cahartsell/DataAcquisition/CAD_files/README.md

Various 3D CAD models for electrical systems on (or related to) the car
