cahartsell/DataAcquisition/AndroidApp/README.md

Android app to download data from on-board data aquisition system over Bluetooth.
