cahartsell/DataAcquisition/Arduino/README.md

## Arduino Source Code

This directory contains all source code intended to run on an Arduino (MEGA ideally)

Written in standard C++ (not arduino C). Compiled and deployed to Arduino using PlatformIO.

Project is configured for Eclipse IDE (Due to PlatformIO support for Eclipse).
