cahartsell/DataAcquisition/PythonBluetoothServer/README.md

Simple Python bluetooth server for testing android app (without Arduino bluetooth)
