cahartsell/DataAcquisition/Documents_Presentations/Baja Innovation Presentation (Auburn Design Review Event).pptx

Bama Racing Innovation

Charles Hartsell & John Mitchell

## Data Acquisition System

- Arduino MEGA 2560
- Data Gathered:
  - Drive Axle RPM
  - Engine RPM
  - Vehicle Acceleration
  - CVT Temperature

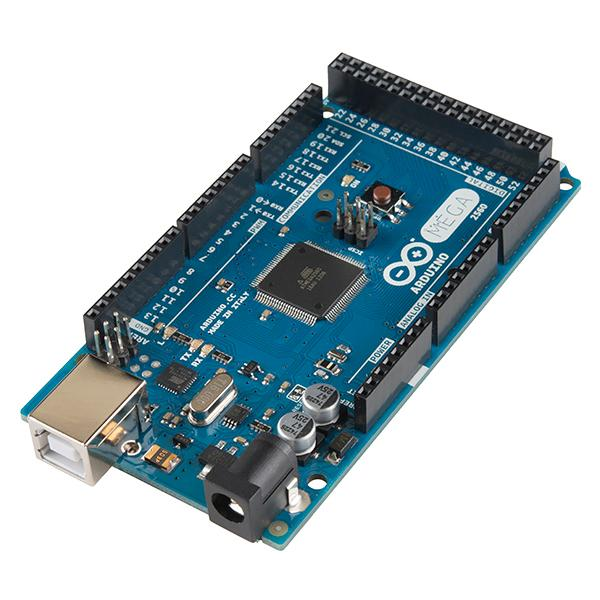
[picture p1: figure]

## Data Logging

- Serial Interface with in-vehicle micro SD card
- Logs data from sensors:
  - Engine RPM
  - Axle RPM
  - Acceleration
- CVT ratio determined using Engine & Axle RPM

## Driver Interface

- 16x2 LCD Display:
  - Current Speed
  - Hour meter
  - Odometer
  - Tachometer

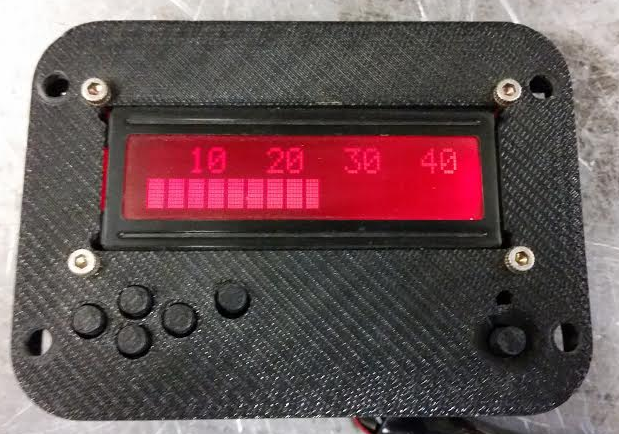
[picture p2: figure]
Screen Clipping

## Engine RPM Sensor

- Capacitive pickup on spark plug wire
- Noisy input
- 74221 monostable multivibrator (aka “one-shot”) used to provide clean rectangular pulse to Arduino

## Axle RPM Sensor

- GM camshaft position sensor (inductive pickup)
- Op-Amp circuit to boost the signal to 5V logic level

## 3-Axis Accelerometer

- I2C interface with microcontroller through 3.3 to 5V Logic Leveler
- Selectable range of ±2g/ ±4g/ ±8g
- Secondary Speed measurement
- Vehicle Orientation

## Power Consumption

- Typical Current Draw:
  - Brake/Reverse Light: 100 mA each
  - Reverse Alarm: 70 mA
  - Arduino: 25 mA under load
  - Sensors/Screen: 20 mA typical
- Significant power consumption by Data Acquisition System
- 5 Ah battery chosen for long battery life (approximately 55 hours)

## Dashboard

- Low-Profile for Driver Visibility
- 3D Printed for ease of manufacture and light weight
- Total Weight (inc. DAS): ~4 lbs

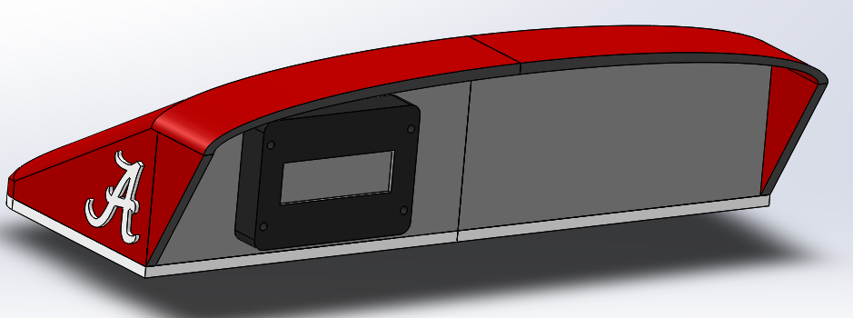
[picture p3: figure]

## Slide 10

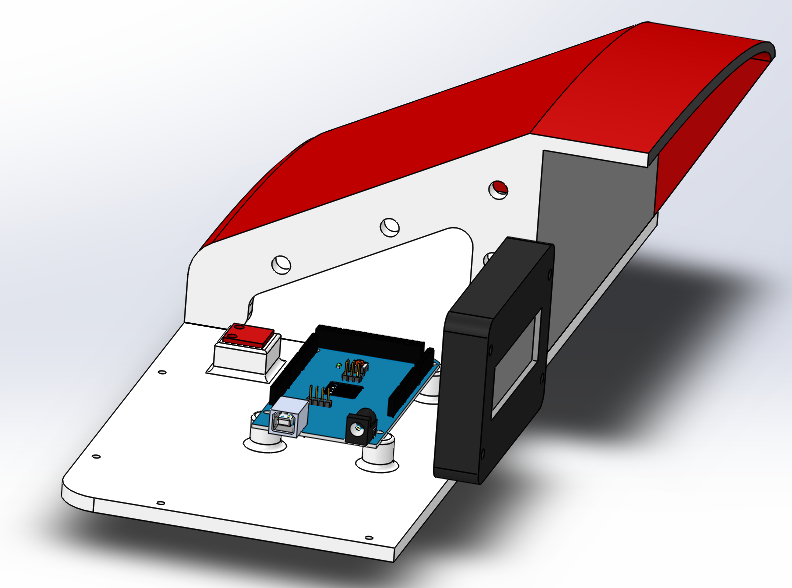
[picture p4: figure]

## Cost Report

- Arduino MEGA: 45.95
- Display: 8.20
- Accelerometer: 9.95
- Position Sensor: 25.28
- Temp Sensor: 1.50
- Misc: ~20.00
- Total: 110.88
- Entire Electrical Cost: 391.78
