cahartsell/DataAcquisition/MATLAB/ExamplePlots.png

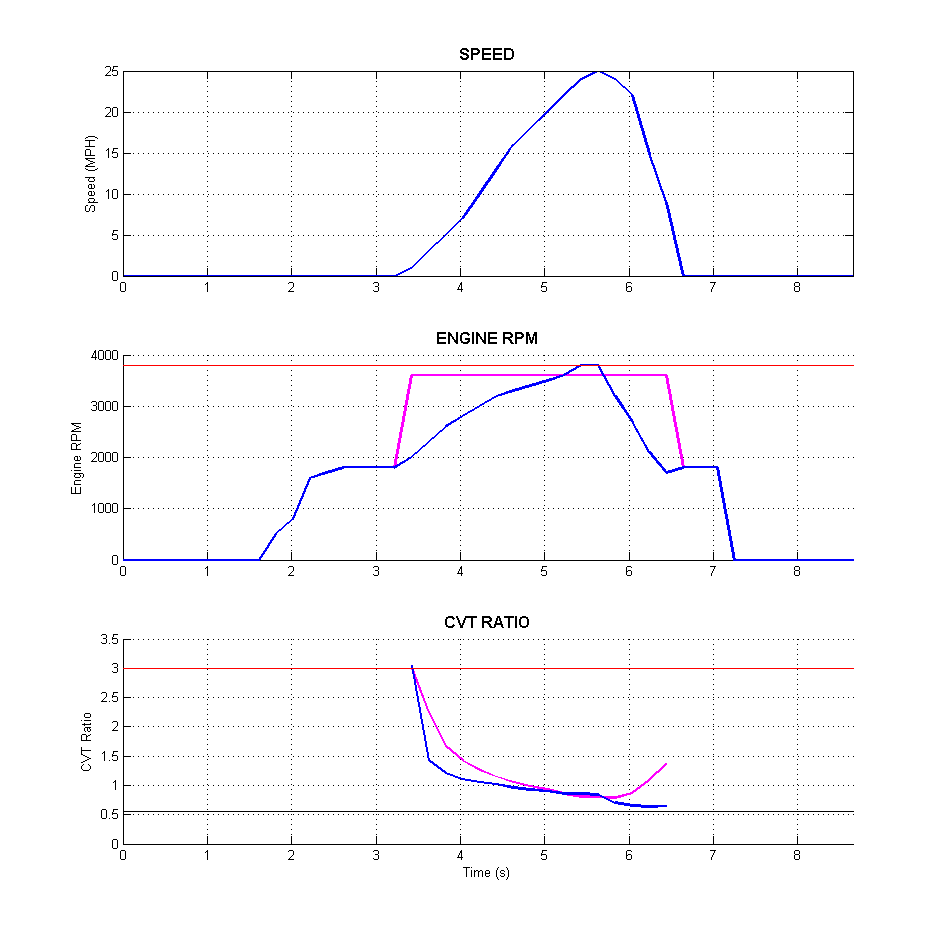
MATLAB/ExamplePlots.png
