cahartsell/DataAcquisition/raspberrypi/component_tests/README.md

Component tests copied over from Arduino code.
Must be converted to a standard C/C++ file using R-PI libraries before running on raspberry pi.
