cahartsell/DataAcquisition/Documents_Presentations/Electrical Ideas Parts List.xlsx

Baja Electrical Parts List: 2014-2015
Part | Amount | Price | Source
Must have:
Back-up/Reverse Light Combo | 1 | $39.78 | http://www.waytekwire.com/item/47945/6-OVAL-DUAL-LED-STOP-TURN/
Connector for Light | 5 | $0.96 | http://www.waytekwire.com/item/47998/CONNECTOR-PIGTAIL-RIGHT-ANGLE-U-S-Made-/
2 Terminal Microswitch | 1 | $1.50 | https://www.sparkfun.com/products/9414
Back-up Alarm | 1 | $22.43 | http://www.waytekwire.com/item/48020/BACK-UP-ALARM-97DB/
 | Total: | $64.67
Needed:
3 Axis Accelerometer | 1 | $9.95 | https://www.sparkfun.com/products/12756
Sparkfun Open Log | 1 | $24.95 | https://www.sparkfun.com/products/9530
Arduino Mega Proto Shield | 1 | $14.95 | http://www.adafruit.com/products/192
Connector 10-Pack (Plugs) | 1 | $3.86 | http://www.mcmaster.com/#69295k99/=vitq33
Connector 10-Pack (Recepticals) | 1 | $3.86 | http://www.mcmaster.com/#69295k8/=vitqj1
Pins 100-Pack | 1 | $11.35 | http://www.mcmaster.com/#69295k111/=vitr4v
Sockets 100-Pack | 1 | $10.27 | http://www.mcmaster.com/#69295k115/=vitr6y
 | Total: | $79.19
Extra:
Inline Watt Meter | 1 | $49.99 | http://www.powerwerx.com/digital-meters/dc-inline-watt-meter-power-analyzer-powerpoles.html
Anderson Powerpoles | 1 | $37.99 | http://www.powerwerx.com/anderson-powerpoles/powerpole-sets/15-amp-red-black-anderson-powerpole-sets.html
 | Total: | $87.98
 | Grand Total: | $167.17
16GB SD Card | 1 | $8.93 | http://www.amazon.com/SanDisk-Memory-SDSDUN-0016G-G46-Newest-Version/dp/B00M55BMKK?s=pc
