cahartsell/DataAcquisition/CAD_files/Dashboard Assembly/HUD Assem2.SLDASM

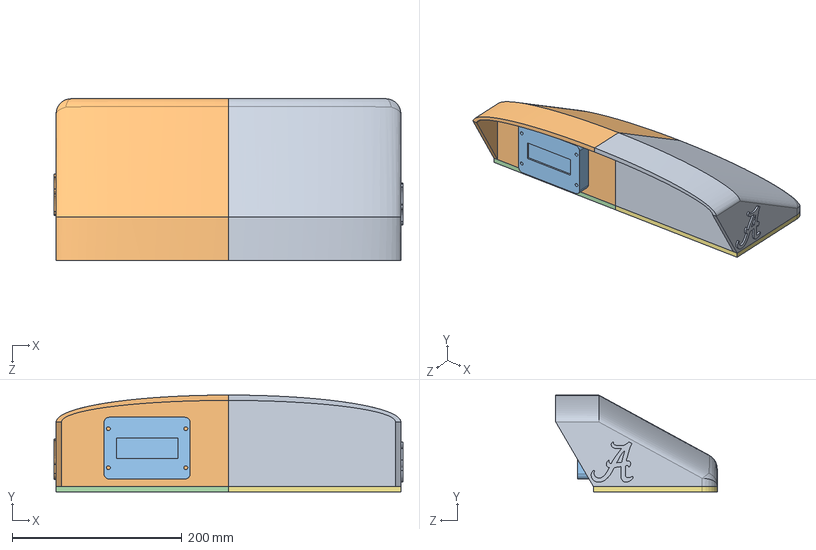
[picture p8: CAD file, 2018-06-14]
CAD_files/Dashboard Assembly/HUD Assem2.SLDASM
411.5 x 114.3 x 190.5 mm
SPLIT HUD 2.1
SPLIT HUD 1.1
LCD Box
Dash Bottom Half
ArduinoMega2560
Accelerometer
Dash Bottom Right Half
