cahartsell/DataAcquisition/CAD_files/Small Dash Assembly V2/Dash Assembly.SLDASM

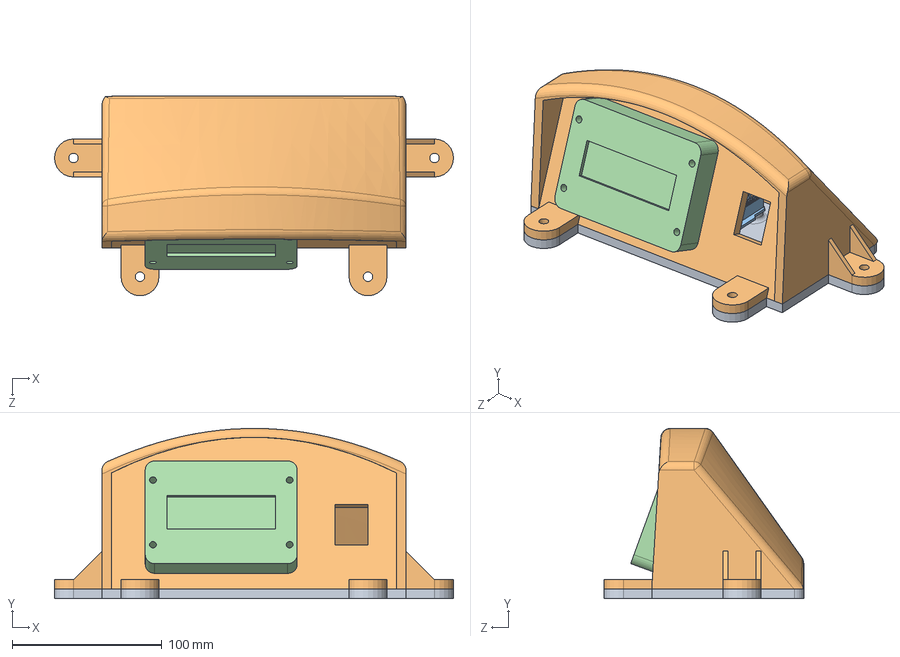
[picture p9: CAD file, 2018-06-14]
CAD_files/Small Dash Assembly V2/Dash Assembly.SLDASM
266.7 x 113.8 x 133.4 mm
Dash Bottom
Dash
ArduinoMega2560
LCD Box
Accelerometer
