cahartsell/DataAcquisition/CAD_files/Small Dash Assembly/Small Dash Assembly.SLDASM

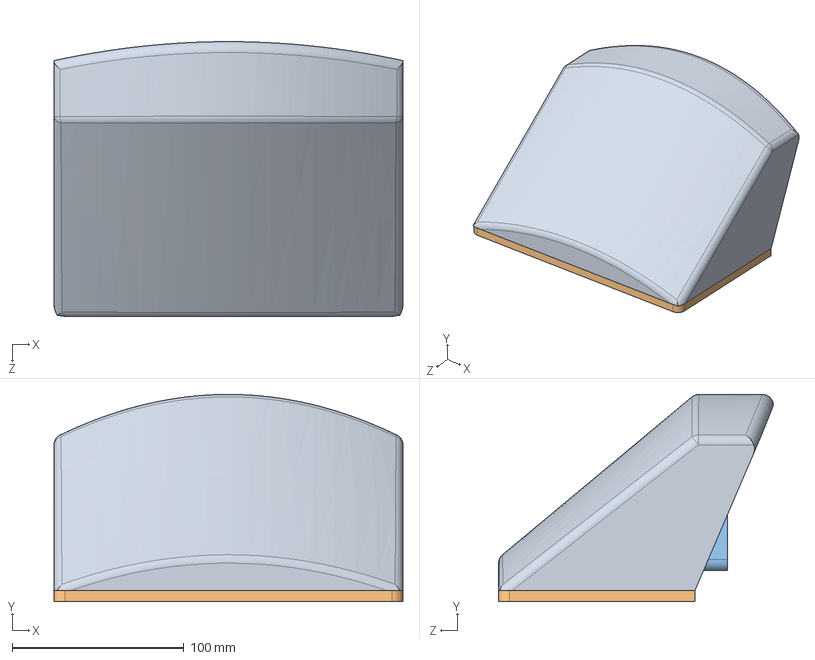
[picture p10: CAD file, 2018-06-14]
CAD_files/Small Dash Assembly/Small Dash Assembly.SLDASM
203.2 x 120.6 x 160.0 mm
Small Dash
Small Dash Bottom
LCD Box
ArduinoMega2560
