cahartsell/DataAcquisition/CAD_files/Small Dash Assembly V2/LCD Box.SLDPRT

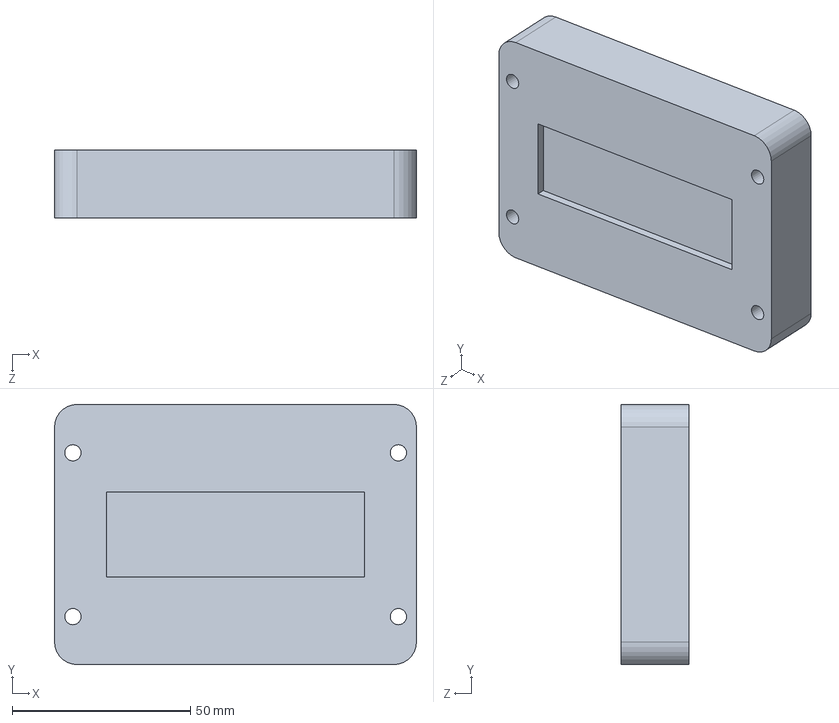
[picture p12: CAD file, 2018-06-14]
CAD_files/Small Dash Assembly V2/LCD Box.SLDPRT
101.6 x 73.0 x 19.1 mm
