cahartsell/DataAcquisition/CAD_files/Small Dash Assembly/Small Dash.SLDPRT

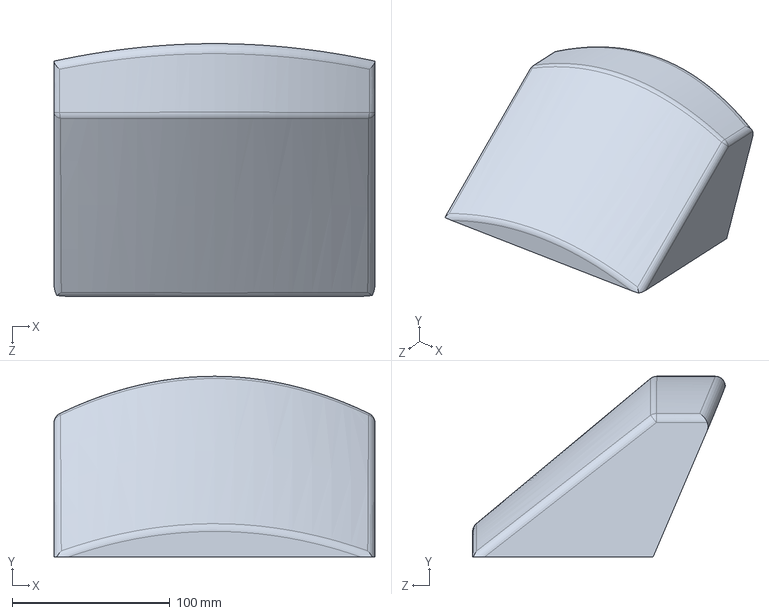
[picture p13: CAD file, 2018-06-14]
CAD_files/Small Dash Assembly/Small Dash.SLDPRT
203.2 x 114.3 x 160.0 mm
