cahartsell/DataAcquisition/CAD_files/Transponder Charging Holder.SLDPRT

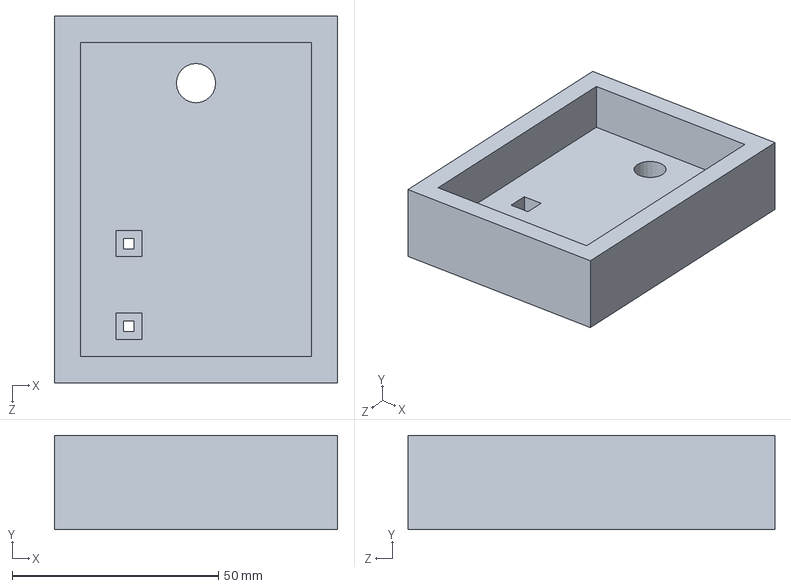
[picture p14: CAD file, 2018-06-14]
CAD_files/Transponder Charging Holder.SLDPRT
68.6 x 22.9 x 88.9 mm
