cahartsell/DataAcquisition/CAD_files/Transponder Charging Holder v2.SLDPRT

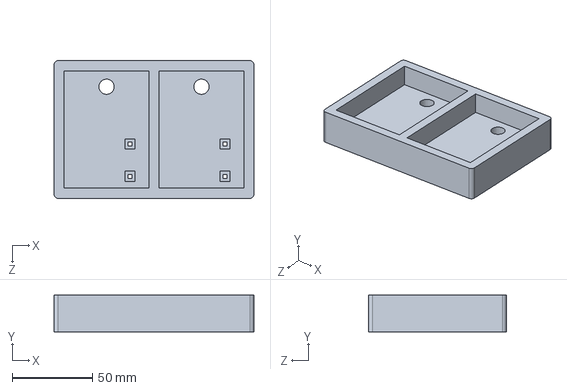
[picture p15: CAD file, 2018-06-14]
CAD_files/Transponder Charging Holder v2.SLDPRT
124.5 x 22.9 x 85.7 mm
