cahartsell/DataAcquisition/CAD_files/Battery Model.SLDPRT

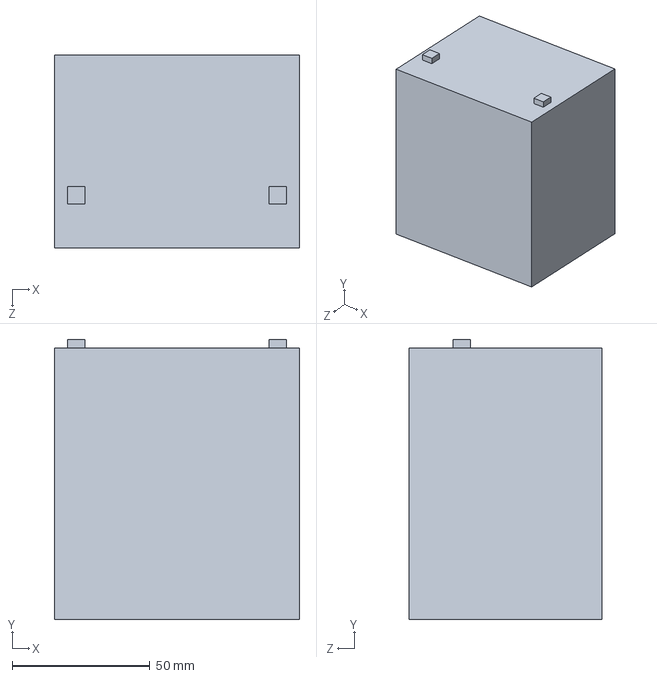
[picture p16: CAD file, 2018-06-14]
CAD_files/Battery Model.SLDPRT
88.9 x 101.6 x 69.8 mm
