cahartsell/DataAcquisition/CAD_files/Dashboard Assembly/Dash Bottom Right Half.SLDPRT

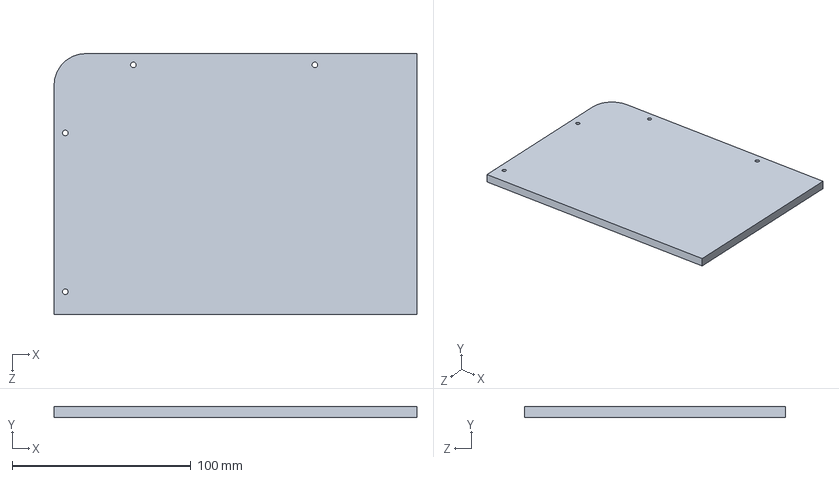
[picture p17: CAD file, 2018-06-14]
CAD_files/Dashboard Assembly/Dash Bottom Right Half.SLDPRT
203.2 x 6.35 x 146.1 mm
