cahartsell/DataAcquisition/CAD_files/Small Dash Assembly V2/Accelerometer.SLDPRT

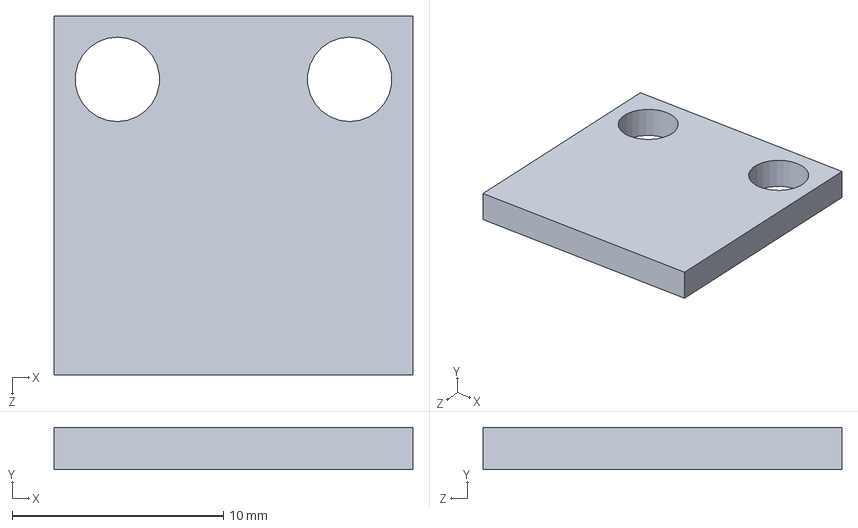
[picture p18: CAD file, 2018-06-14]
CAD_files/Small Dash Assembly V2/Accelerometer.SLDPRT
17.0 x 2.00 x 17.0 mm
