cahartsell/DataAcquisition/CAD_files/Dashboard Assembly/ArduinoMega2560R3.stp

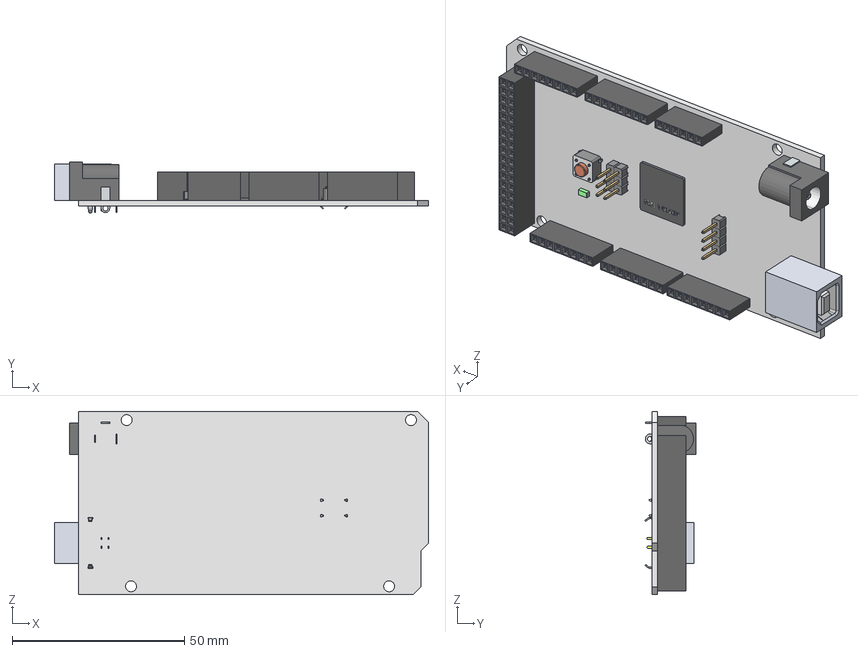
[picture p19: CAD file, 2018-06-14]
CAD_files/Dashboard Assembly/ArduinoMega2560R3.stp
108.6 x 14.9 x 53.2 mm
PCB-FIXED
