cahartsell/DataAcquisition/CAD_files/Small Dash Assembly V2/Dash.SLDPRT

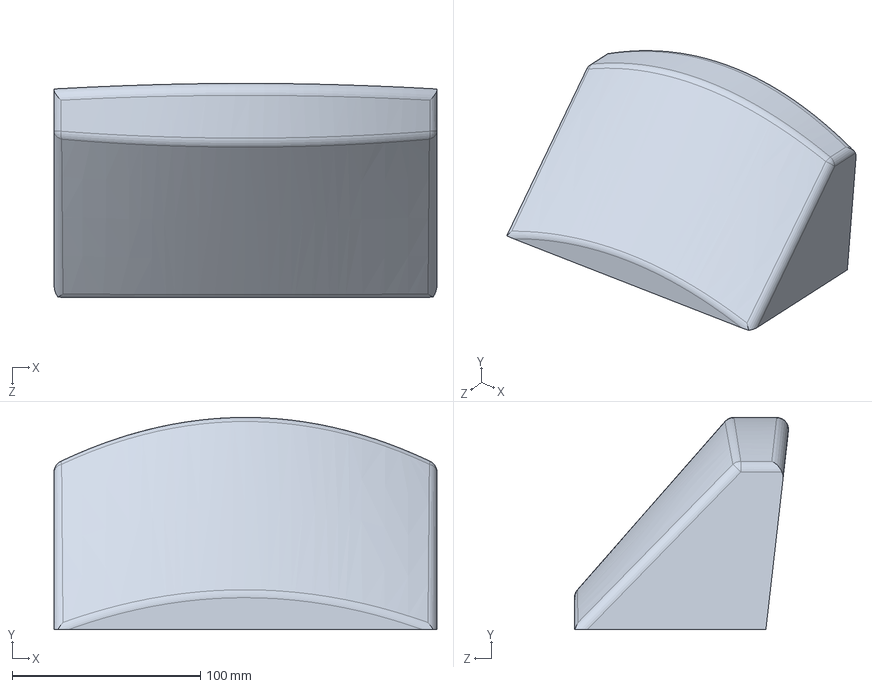
[picture p20: CAD file, 2018-06-14]
CAD_files/Small Dash Assembly V2/Dash.SLDPRT
203.2 x 112.6 x 113.6 mm
