cahartsell/DataAcquisition/CAD_files/Small Dash Assembly/Small Dash Bottom.SLDPRT

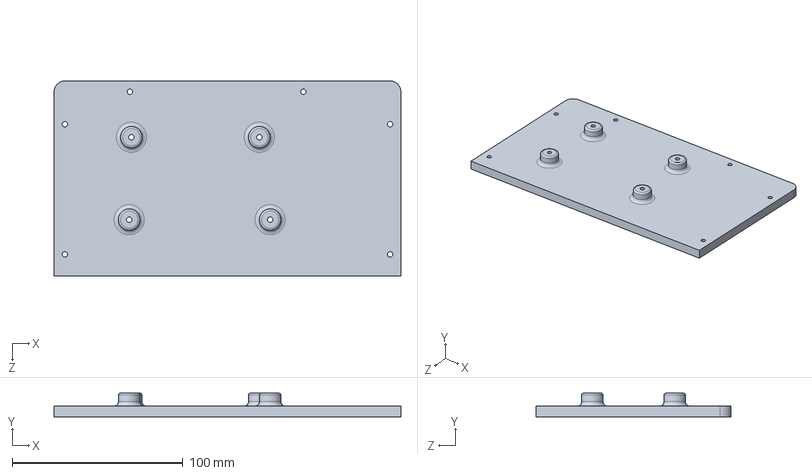
[picture p21: CAD file, 2018-06-14]
CAD_files/Small Dash Assembly/Small Dash Bottom.SLDPRT
203.2 x 14.0 x 114.3 mm
