cahartsell/DataAcquisition/CAD_files/Dashboard Assembly/SPLIT HUD 2.1.SLDPRT

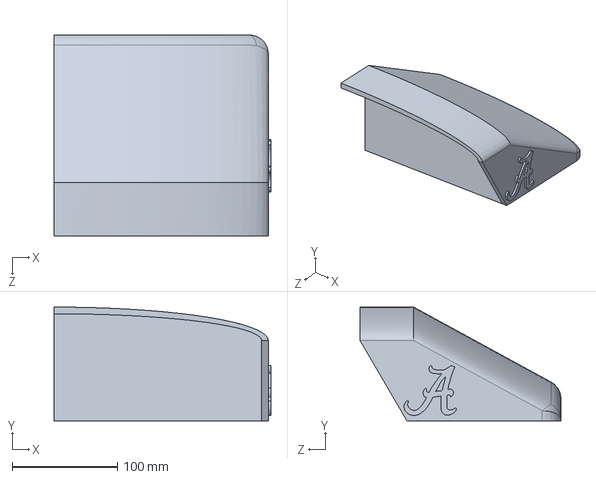
[picture p22: CAD file, 2018-06-14]
CAD_files/Dashboard Assembly/SPLIT HUD 2.1.SLDPRT
205.7 x 108.0 x 190.5 mm
