cahartsell/DataAcquisition/CAD_files/Small Dash Assembly V2/Dash Bottom.SLDPRT

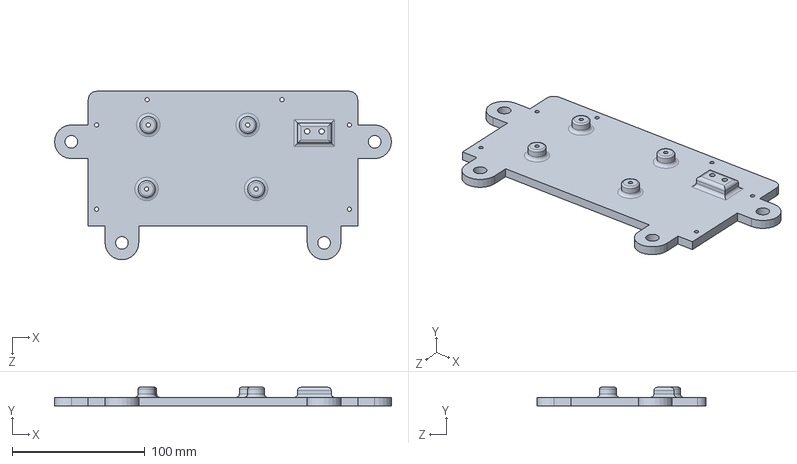
[picture p23: CAD file, 2018-06-14]
CAD_files/Small Dash Assembly V2/Dash Bottom.SLDPRT
254.0 x 14.0 x 127.0 mm
