cahartsell/DataAcquisition/CAD_files/Dashboard Assembly/Dash Bottom Half.SLDPRT

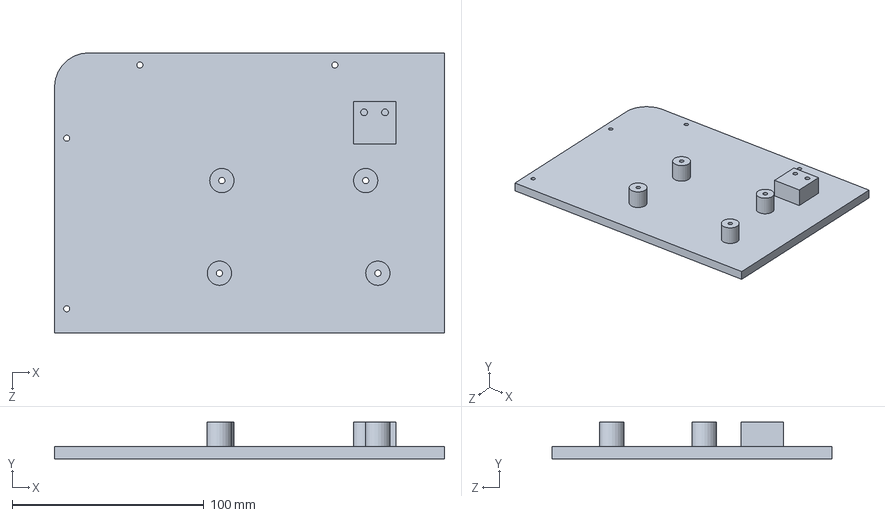
[picture p24: CAD file, 2018-06-14]
CAD_files/Dashboard Assembly/Dash Bottom Half.SLDPRT
203.2 x 19.1 x 146.1 mm
