cahartsell/DataAcquisition/CAD_files/Dashboard Assembly/Arduino Mega Case.SLDPRT

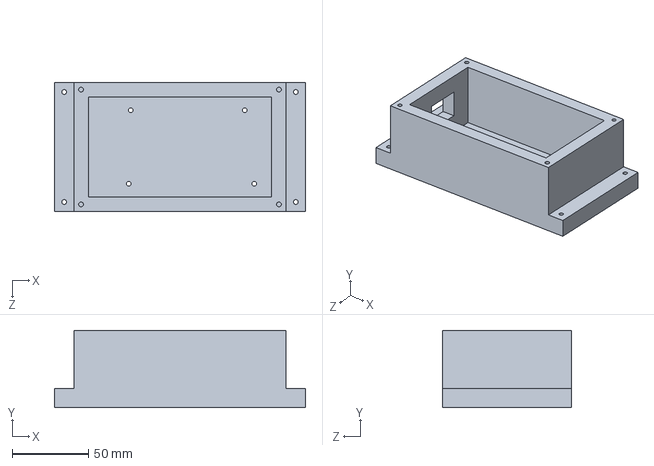
[picture p25: CAD file, 2018-06-14]
CAD_files/Dashboard Assembly/Arduino Mega Case.SLDPRT
165.1 x 50.8 x 85.1 mm
