cahartsell/DataAcquisition/CAD_files/Dashboard Assembly/Arduino Mega Case Lid.SLDPRT

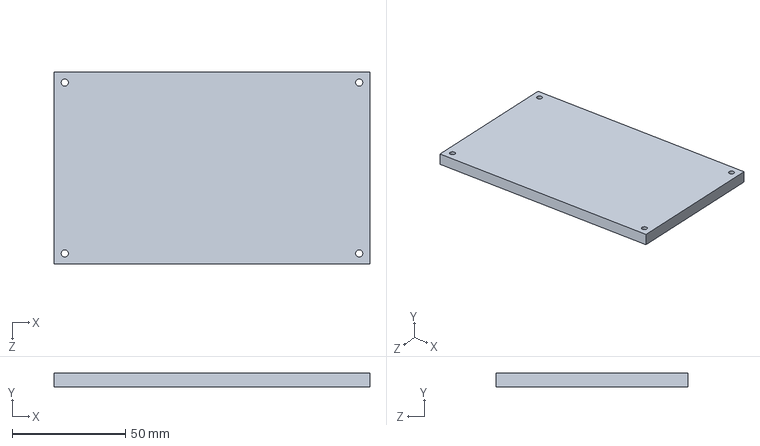
[picture p26: CAD file, 2018-06-14]
CAD_files/Dashboard Assembly/Arduino Mega Case Lid.SLDPRT
139.7 x 6.35 x 85.1 mm
