cahartsell/DataAcquisition/(list of files, cad)

Other CAD files:
CAD_files/Small Dash Assembly/ArduinoMega2560.SLDPRT
CAD_files/Dashboard Assembly/SPLIT HUD 1.1.SLDPRT
CAD_files/Small Dash Assembly V2/ArduinoMega2560.SLDPRT
CAD_files/Dashboard Assembly/LCD Box.SLDPRT
CAD_files/Small Dash Assembly V2/Dash Bottom.STL
CAD_files/Small Dash Assembly V2/Dash.STL
