cahartsell/DataAcquisition/CAD_files/Dashboard Assembly/Screenshots.docx

Mass = ~3.70 lbs inc. LCD Box

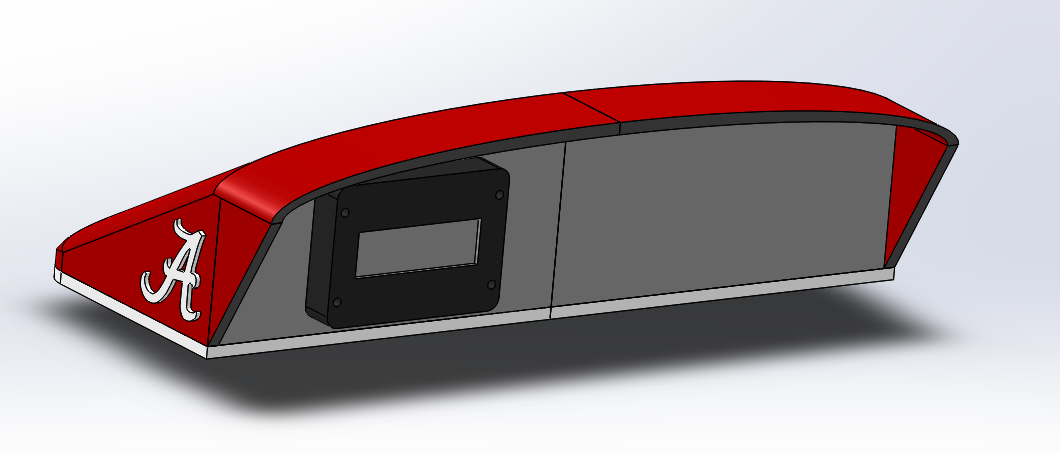
[picture p27: figure]
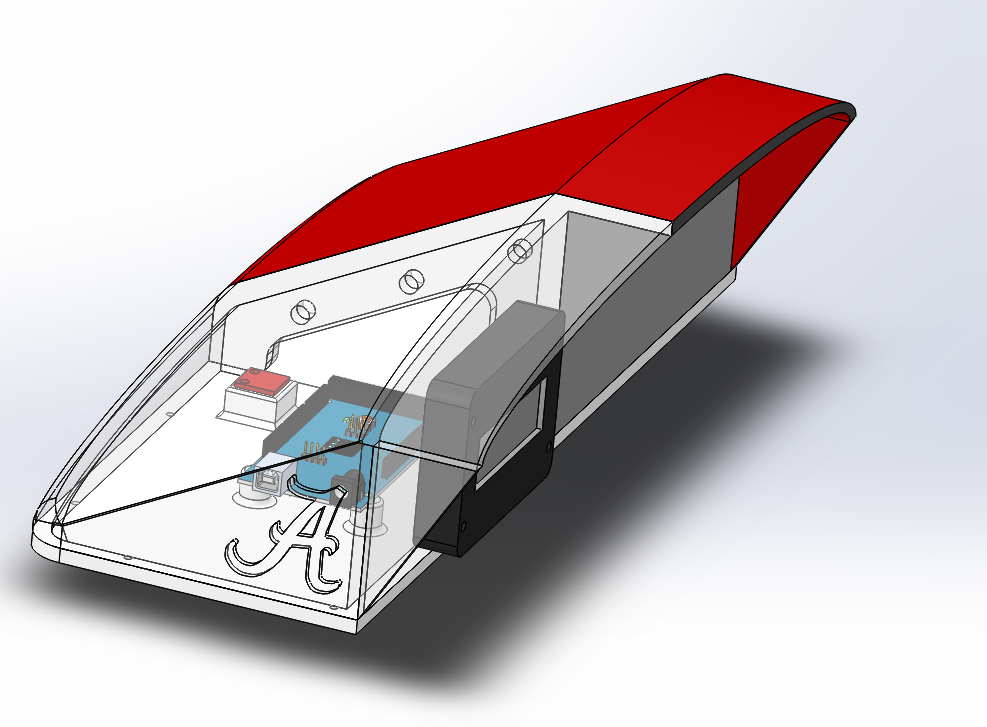
[picture p28: figure]
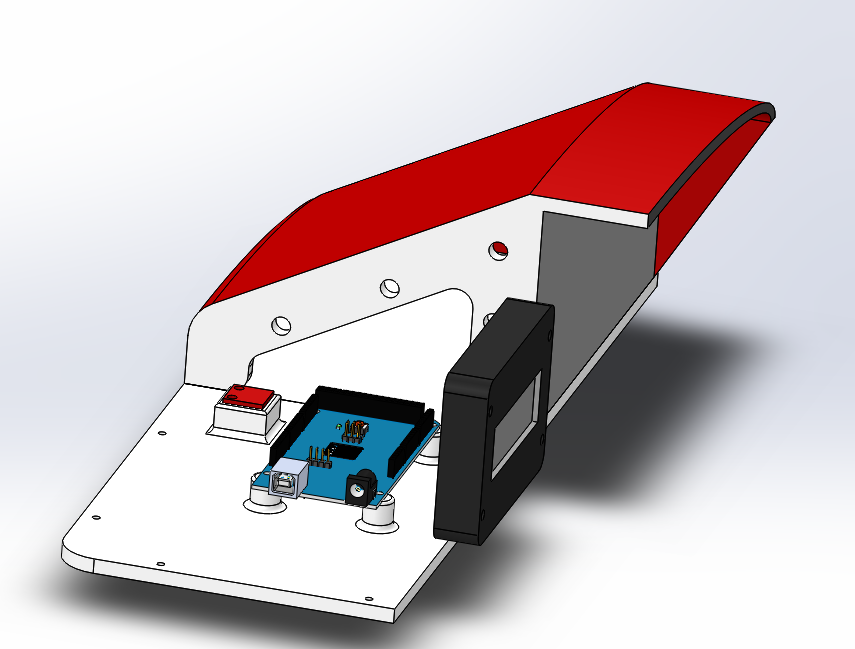
[picture p29: figure]
