cahartsell/DataAcquisition/(list of files, drawings)

Other design files:
PCB Files/bajaV1.dip
PCB Files/bajaV2.dip
