cahartsell/DataAcquisition/(commit log)

2018-06-14 Consolidated files into single repo
    [Accelerometer.SLDPRT, Arduino Mega Case Lid.SLDPRT, Arduino Mega Case.SLDPRT, ArduinoMega2560.SLDPRT, ArduinoMega2560R3.stp, Battery Model.SLDPRT, Dash Assembly.SLDASM, Dash Bottom Half.SLDPRT]
2018-07-10 Initial C++ project for raspberry pi
2018-07-15 Added wiringPi library as submodule
2018-07-15 Added raspberry pi GPIO test
2018-07-23 Reorganized repo and added initial raspberry pi code
2018-07-23 Bug fixes in raspberry pi code and modified DevVM startup script
    [logger.cpp, sparkplugsensor.cpp, sparkplugsensor.h]
2018-07-23 Compiled wiringPi library
2018-07-24 Small bug fix with ISR
    [sparkplugsensor.cpp]
2018-07-25 Bug fix with volatile timespec in ISR
    [sparkplugsensor.cpp]
2018-07-25 Bug fix with gettime in ISR
    [sparkplugsensor.cpp]
2018-07-28 Fixed issues cross compiling to Raspberry Pi
    [logger.cpp, main.cpp, sensorbase.h, sparkplugsensor.cpp]
